kjans123/BME590-LightDHF/Electronics/IMG_3812.JPG

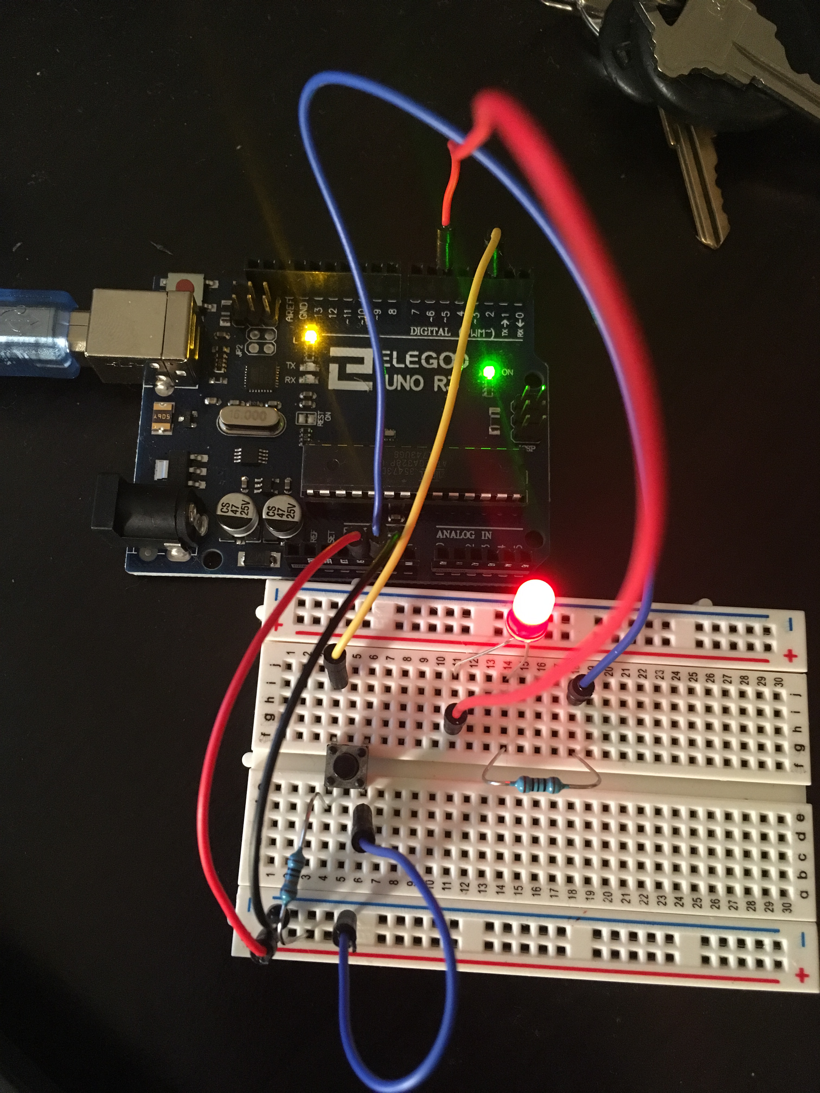
Electronics/IMG_3812.JPG
