kjans123/BME590-LightDHF/Mechanical/LEDlightHolder/JPGs/render.JPG

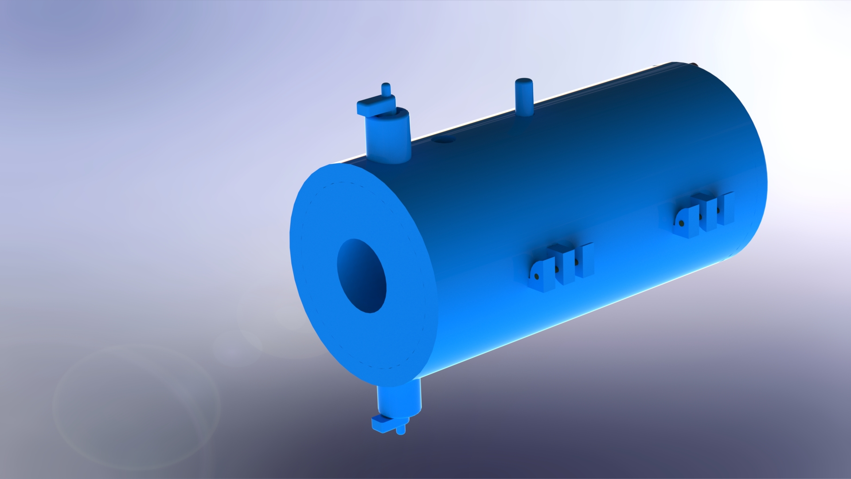
Mechanical/LEDlightHolder/JPGs/render.JPG
