kjans123/BME590-LightDHF/README.md

# BME590-LightDHF
Design History Files & project plan for BME 590 LED light design challenge
test
