kjans123/BME590-LightDHF/Mechanical/MechNotes.txt

10/24/2018:
bulb_grommet_holder V1 is based on 9600K115 grommet from McMaster Carr (https://www.mcmaster.com/9600k115)
the bulb holder for V1 is found here: (https://www.amazon.com/gp/product/B06XRZ3M39/ref=oh_aui_detailpage_o00_s00?ie=UTF8&psc=1)
PRINTED bulb_grommet_holderV1 on 10/24/2018

10/29/2018:
bulb_grommet_holderV2 has outer hole dimension increased from 23mm to 24mm. Also increased lip-hole from 17.46mm to 17.9 mm
PRINTED bulb_grommet_holderV2 on 10/29/2018
