kjans123/BME590-LightDHF/Electronics/ElecNotes.txt

9-27-2018: decided to use analog based design for the BME590 design challenge
10-25-2018: Not going with analog based design. Using Arduino Pro Mini MCU
