kjans123/BME590-LightDHF/Mechanical/ShockConcepts&Filtering.xlsx

Concept # | Concept Desc. | Ease to Design in SW | Ease to find Correct Parts | Expected Weight addition | Expected Shock Absorption | Score
1 | Rubber Feet (heavy rubber feet to absorb shock. If heavy enough, will ensure light rotates mid-air and lands on them due to center of gravity) | 5 | 4 | 1 | 4 | 70%
2 | Suspended electronics inside of flashlight tube (i.e., have an electronics "box" inside tube suspended in mid-air via rubber bands) | 2 | 3 | 4 | 5 | 70%
3 | Anchored electronics inside of flashlight tube (i.e., have an electronics "box" inside tube anchored to tube via rubber, shock-absorbing columns) | 3 | 4 | 3 | 5 | 75% | *
4 | Thick plastic casing + inner foam | 4 | 4 | 2 | 5 | 75%
5 | Thick Rubber banding down the length of the flashlight tube at intervals | 5 | 3 | 3 | 4 | 75% | *
