kjans123/BME590-LightDHF/Docs/Concepts&FilteringDoc.xlsx

Concept # | Concept Desc. | Cost | Time to Implement | Personal Knowledge | Estimated power consumption | Estimated Weight | Score
1) | MCU | 3 | 5 | 5 | 2 | 4 | 76%
2) | Really complex, CAD designed push button to switch between dimming/flashing circuits | 4 | 2 | 4 | 4 | 3 | 68%
3) | Multiple timer chips | 4 | 3 | 3 | 4 | 3 | 68%
4) | Demultiplexer/logic based circuit | 4 | 2 | 1 | 3 | 2 | 48%
 | Scores from 1-5, 5 being most desirable and 1 being least desirable
