kjans123/BME590-LightDHF/Electronics/V2CircuitDiagram.pdf

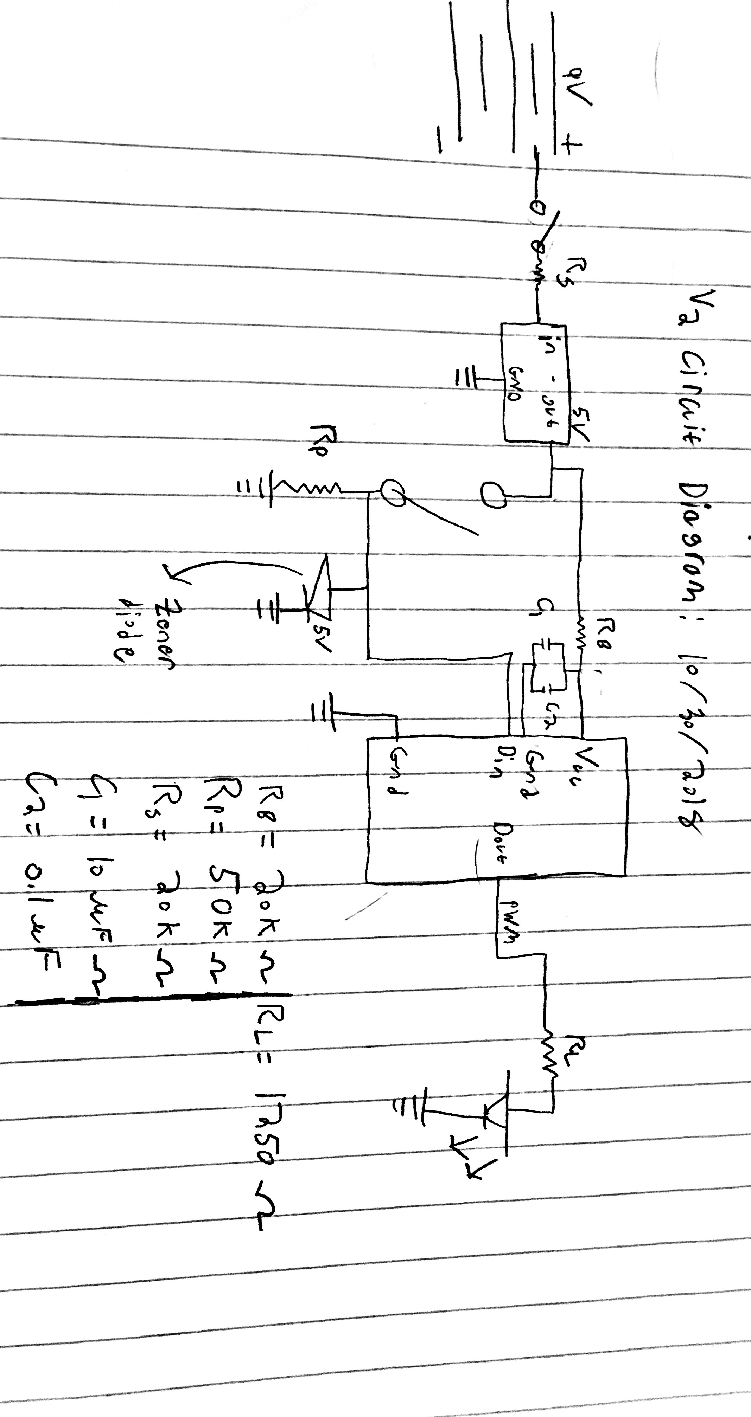
[picture p3: page 1]
