kjans123/BME590-LightDHF/Mechanical/RoughSketchV1.pdf

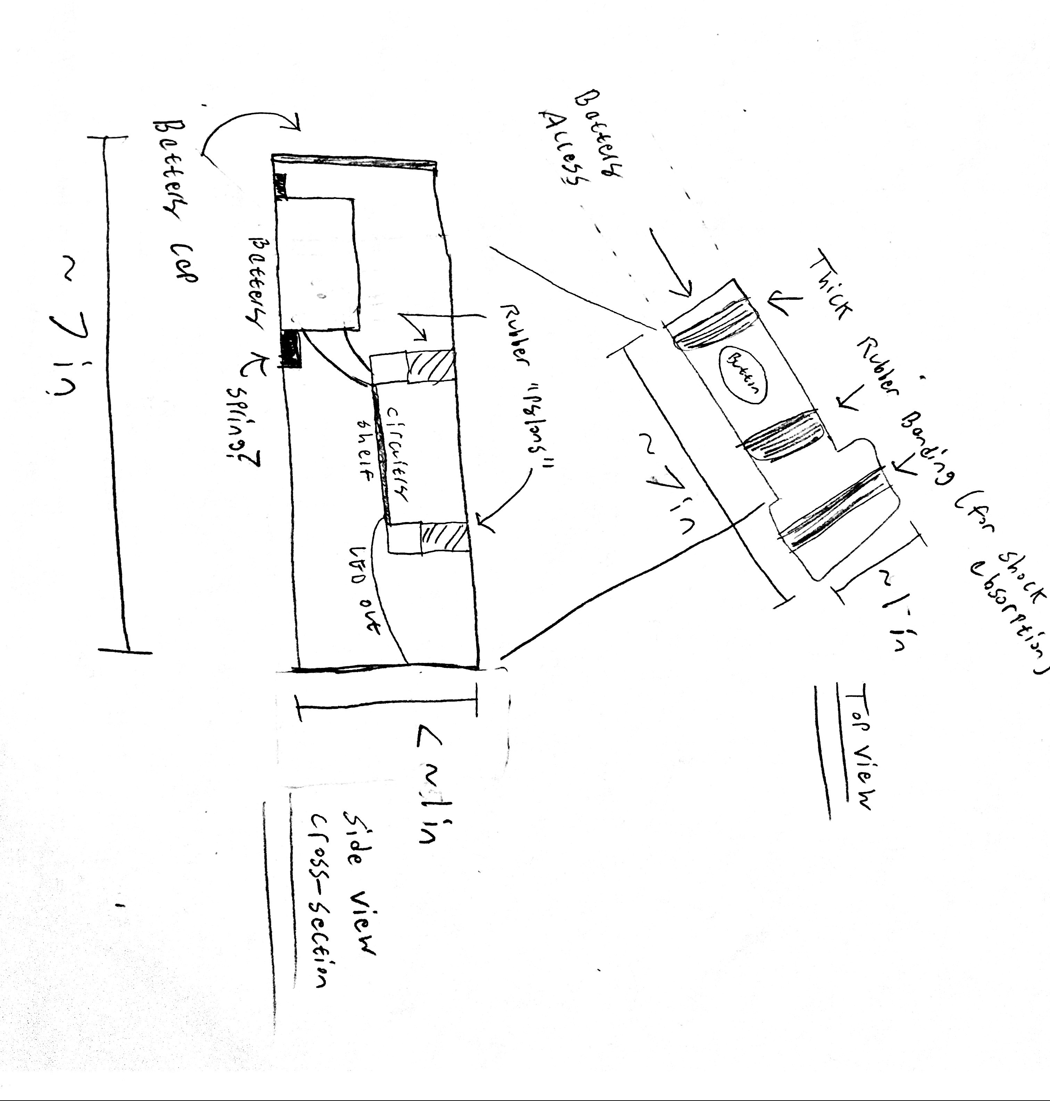
[picture p4: page 1]
