kjans123/BME590-LightDHF/Electronics/FuncBlockDiagram.pdf

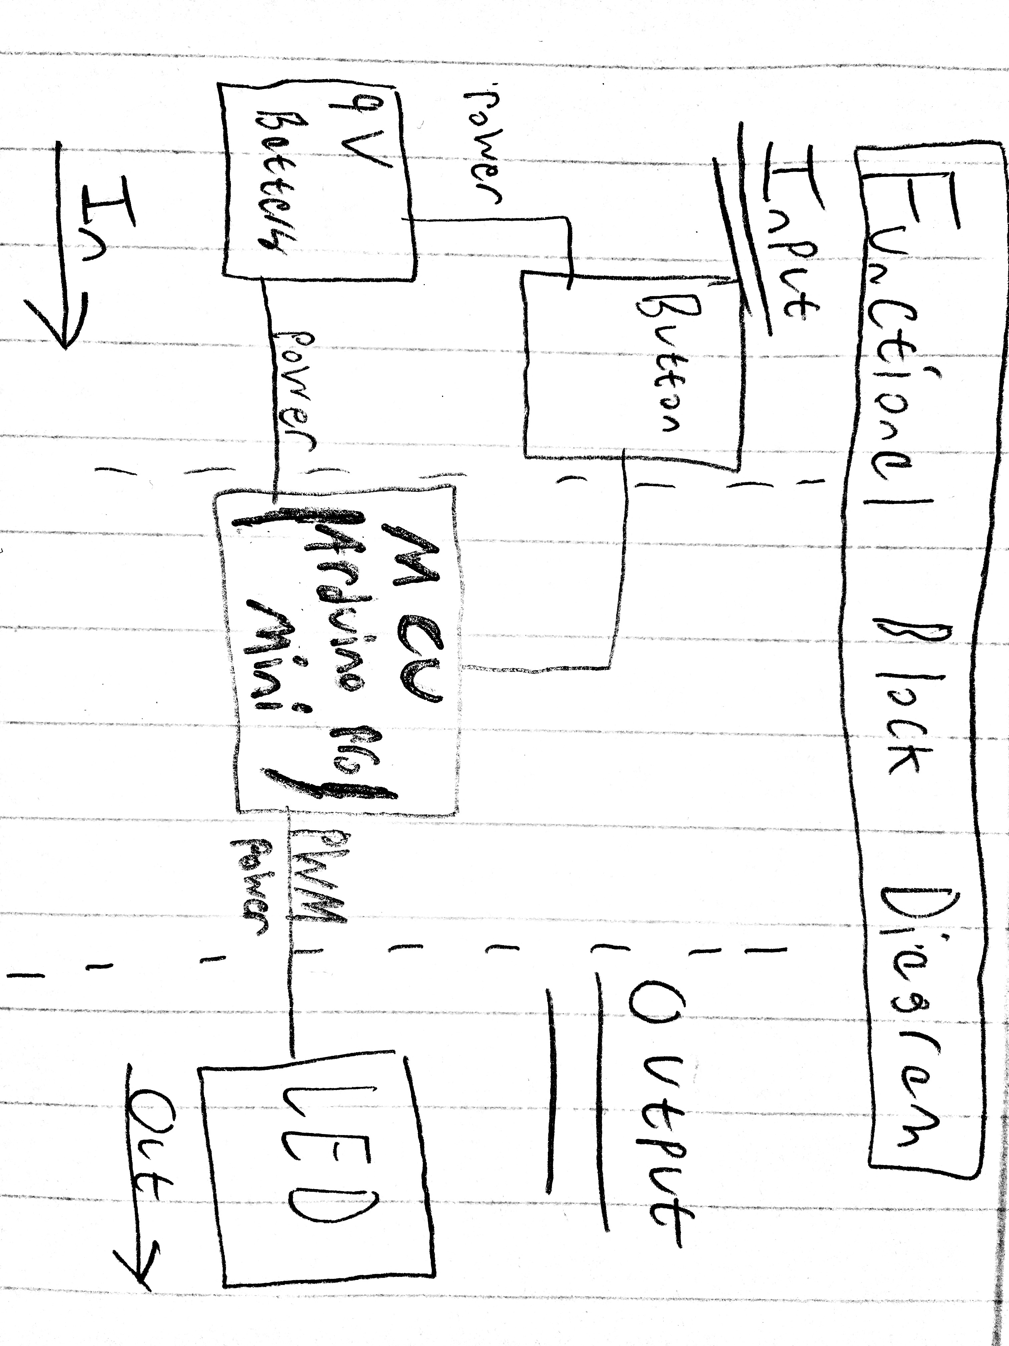
[picture p5: page 1]
