kjans123/BME590-LightDHF/Software/V1SoftwareFlowchart.pdf

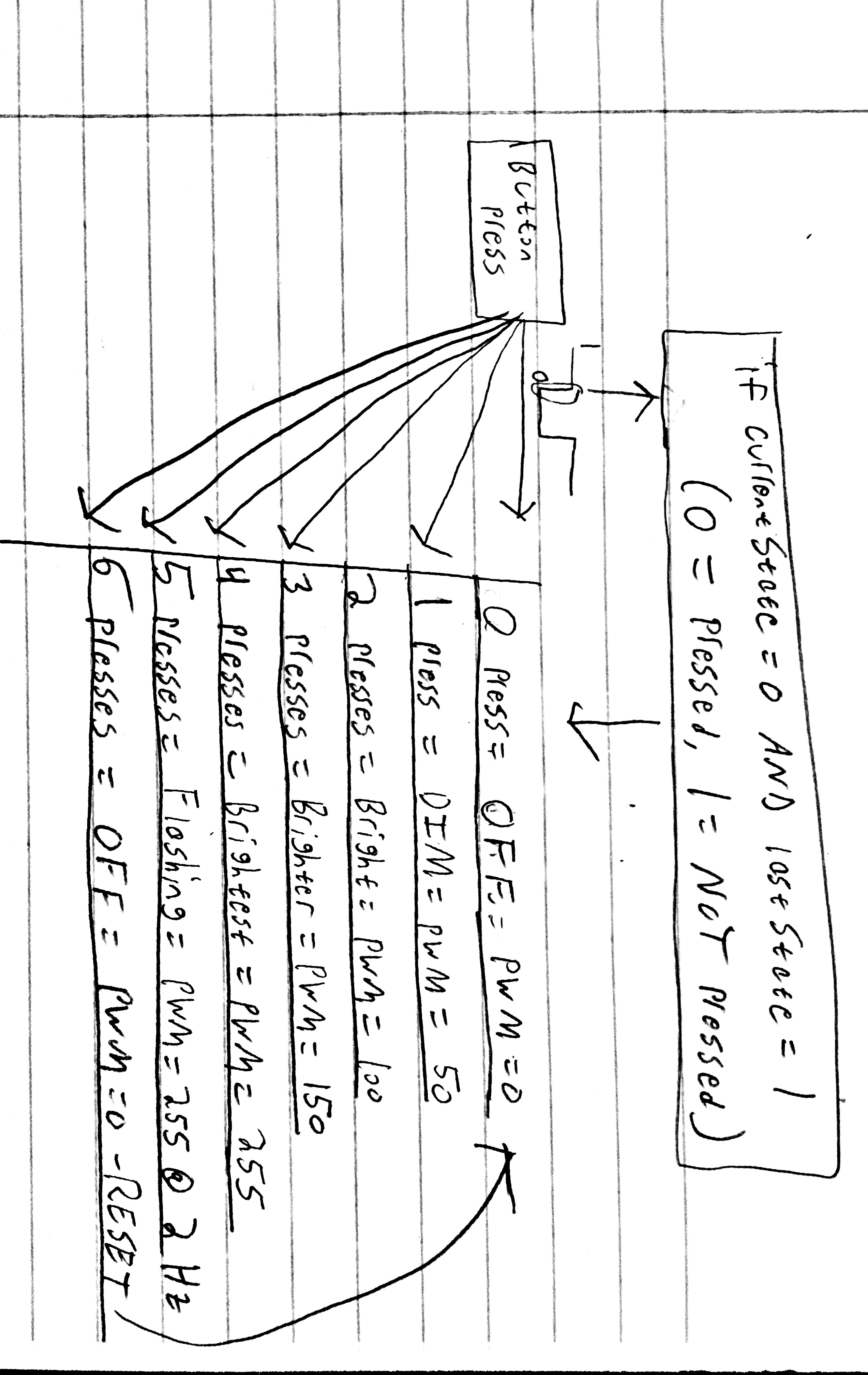
[picture p6: page 1]
