kjans123/BME590-LightDHF/Electronics/Archive/timer555chip_calcs.xlsx

frequency: | 2 | Hz
R1 | 5000 | Ohms | 5k
t1 | 0.2512128972 | second
t2 | 0.2487868868 | second
R2 | 512749 | Ohms | 512.749 | kOhms
1.00975136
C | 6.9999865e-07 | Farads
 | 0.69999865 | uF | .7 uF
 | *will need 2 0.45 uF capacitors in parallel
f | 2.000000864 | Hz
