kjans123/BME590-LightDHF/Electronics/Archive/V1CircuitDiagram.pdf

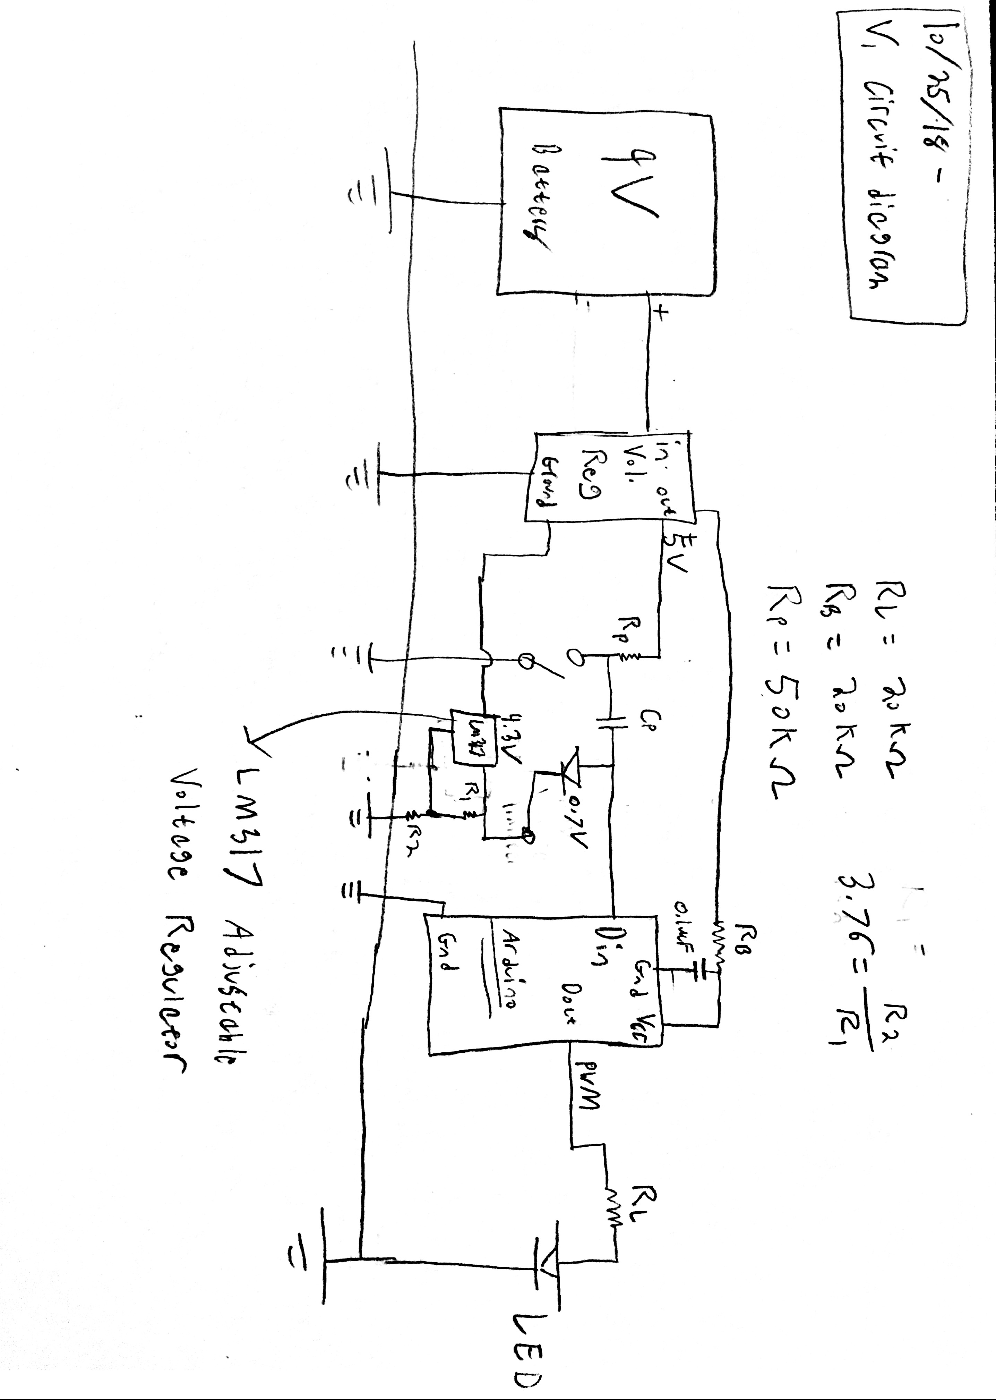
[picture p7: page 1]
