kjans123/BME590-LightDHF/Electronics/eagle_sketch&boardV3/v3board.png

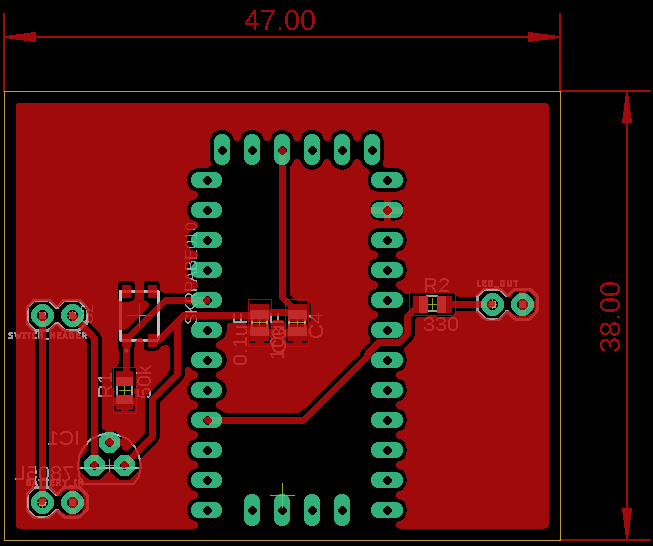
Electronics/eagle_sketch&boardV3/v3board.png
