kjans123/BME590-LightDHF/Electronics/eagle_sketchV1/eagle_sketchV1.png

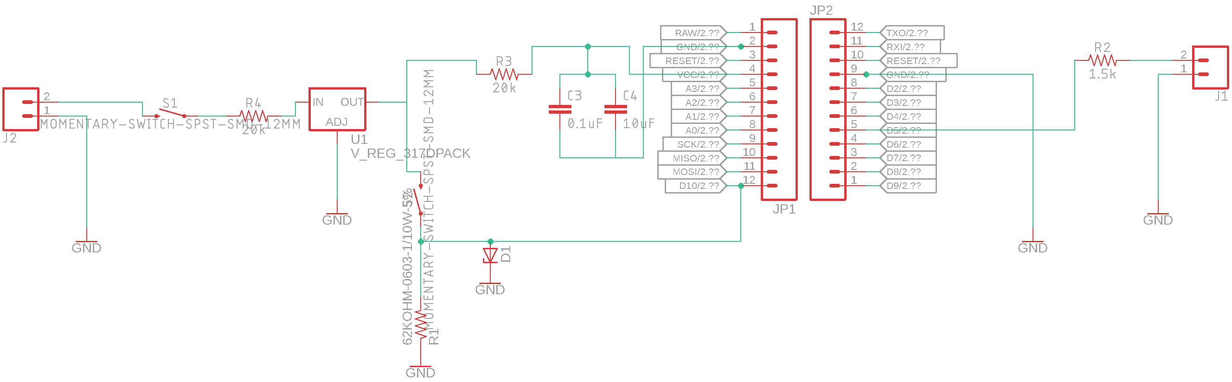
Electronics/eagle_sketchV1/eagle_sketchV1.png
