kjans123/BME590-LightDHF/Mechanical/LEDlightHolder/JPGs/fullAssem2.JPG

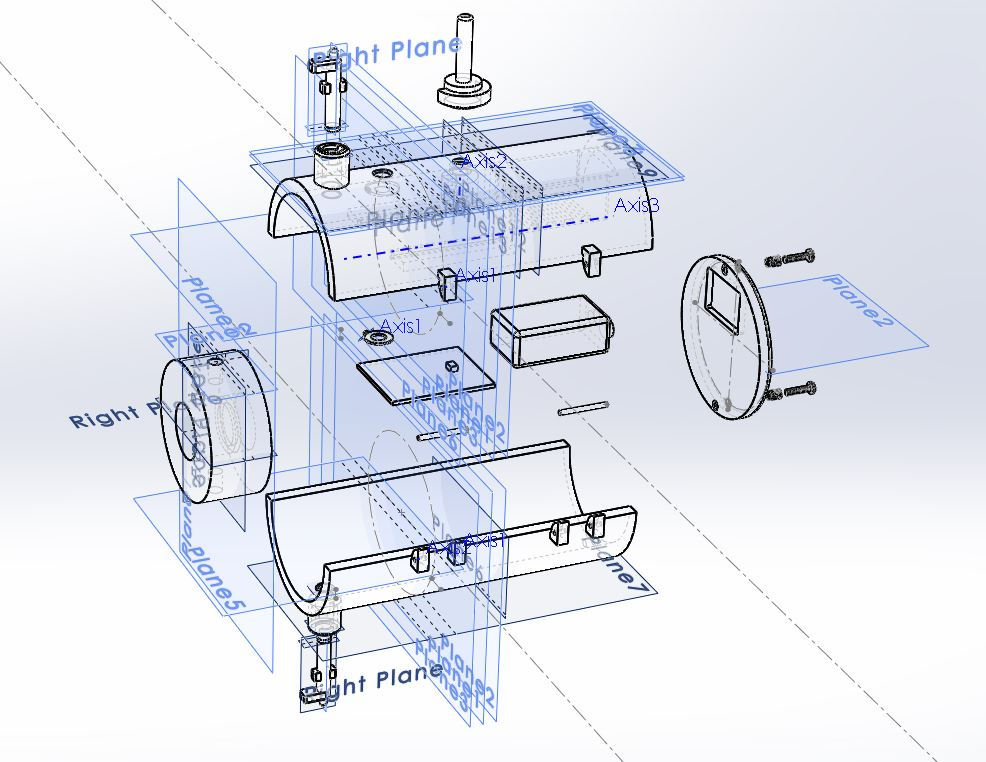
Mechanical/LEDlightHolder/JPGs/fullAssem2.JPG
