kjans123/BME590-LightDHF/Mechanical/LEDlightHolder/JPGs/fullAssem3.JPG

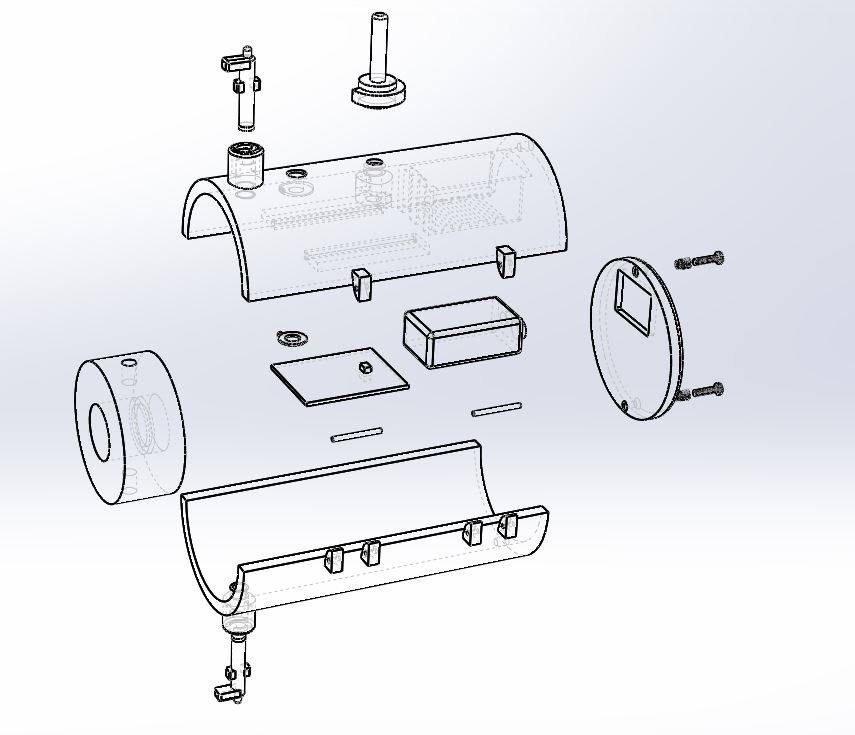
Mechanical/LEDlightHolder/JPGs/fullAssem3.JPG
