kjans123/BME590-LightDHF/Mechanical/LEDlightHolder/JPGs/fullAssem.JPG

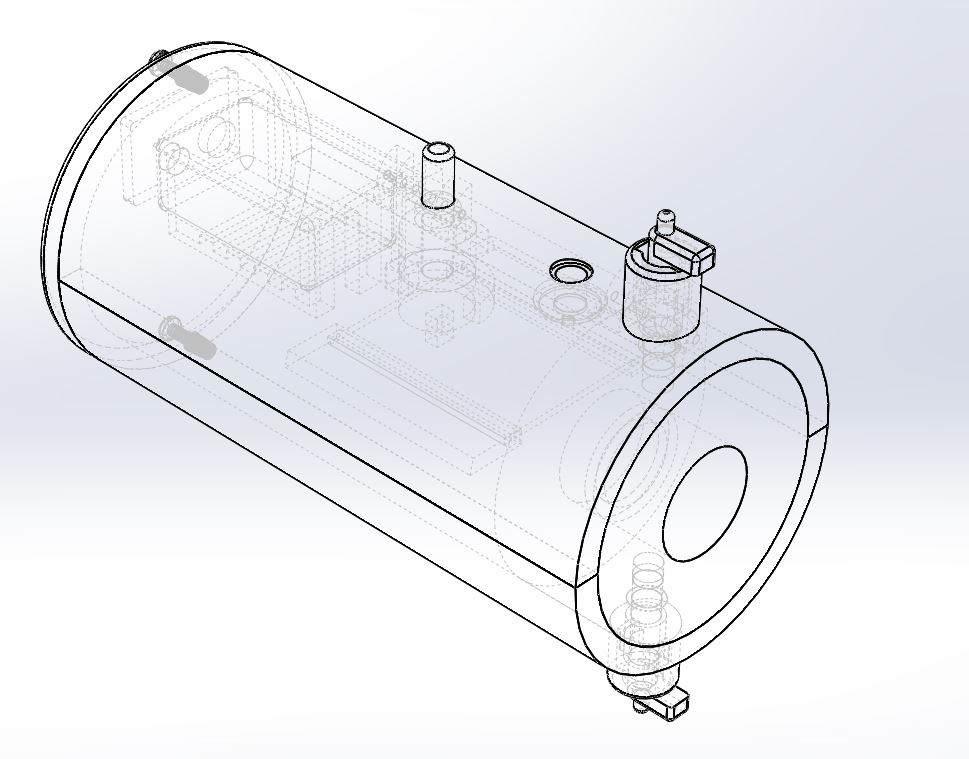
Mechanical/LEDlightHolder/JPGs/fullAssem.JPG
