kjans123/BME590-LightDHF/Mechanical/LEDlightHolder/Main_Enclosure/JPGs/fullAssem4.JPG

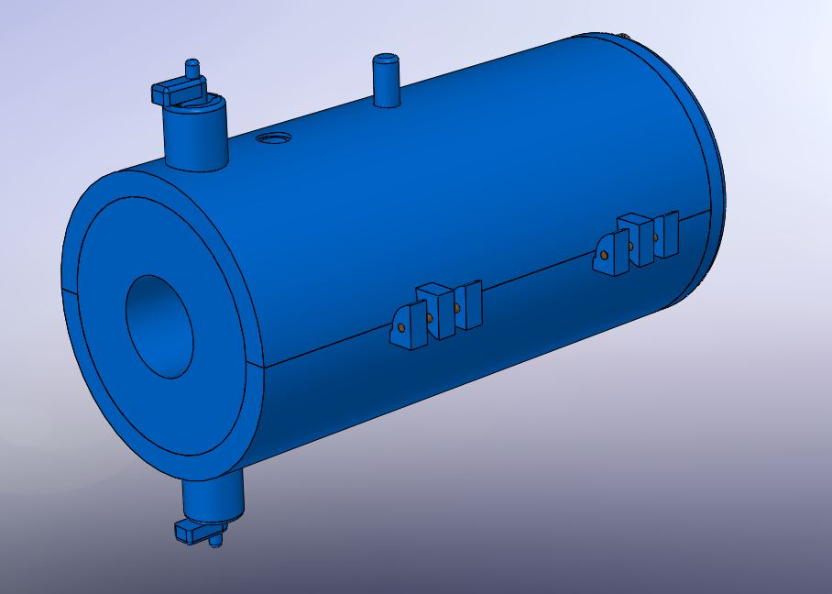
Mechanical/LEDlightHolder/Main_Enclosure/JPGs/fullAssem4.JPG
