kjans123/BME590-LightDHF/Electronics/MCU_details_and_scoring.xlsx

Score | MCU Model | Power Drain on Sleep | Size (LxW) | Cost | Link
4 | Teensy 3.2 | cannot find. Need to test physically | 1.4x0.7in | $24.49 | here (https://www.amazon.com/PJRC-6485230-Teensy-3-2/dp/B015M3K5NG)
1 | Arduino PRO Mini w/ 328P 5V | 54 uA | 1.3x0.71in | $12.99 | here (https://www.amazon.com/Arduino-Pro-Mini-328-16MHz/dp/B004G53J5I)
3 | Arduino Nano V3 | 2 mA | 1.7x0.7in | $4.19 per piece | here (https://www.amazon.com/UCTRONICS-ATmega328P-Controller-Development-Arduino/dp/B07DKZCRQH?s=pc)
5 | Teensy 3.5 | cannot find. Need to test physically | 2.4x0.7in | $27.93 | here (https://www.amazon.com/PJRC-3267-Teensy-3-5/dp/B072JL5C2G)
2 | Teensy 2.0 | 0.23 mA @ 3.3V | 1.2x0.7in | $20.00 | here (https://www.amazon.com/Teensy-2-0/dp/B00NC43256)
