kjans123/BME590-LightDHF/Mechanical/LEDlightHolder/SWParts/fullAssem.SLDASM

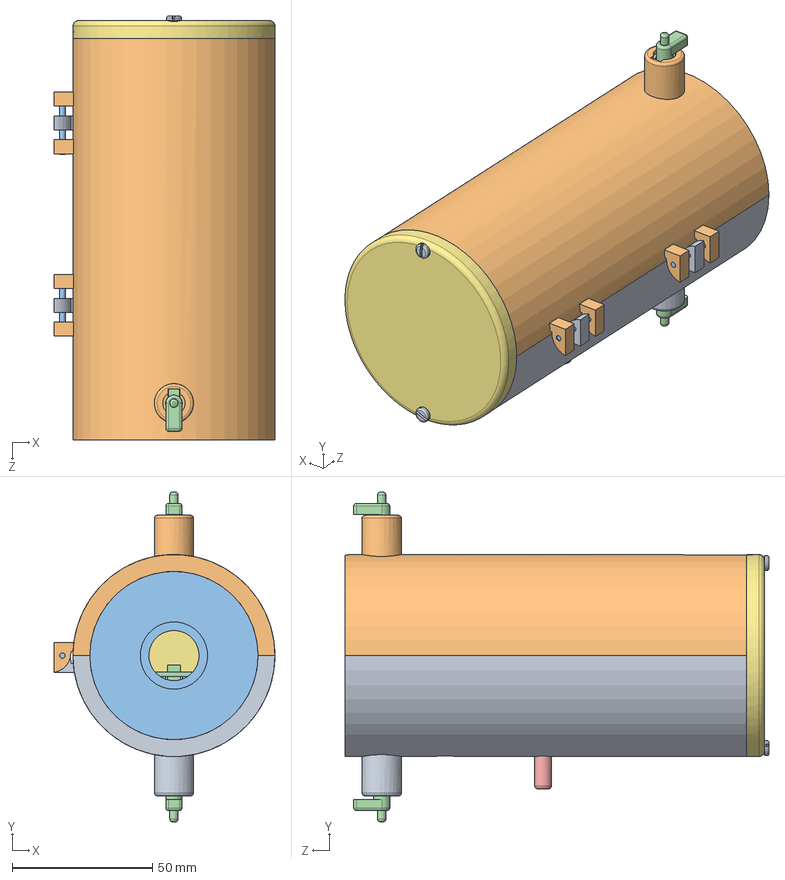
[picture p15: CAD file, 2018-11-29]
Mechanical/LEDlightHolder/SWParts/fullAssem.SLDASM
78.7 x 117.5 x 151.1 mm
main_enc_actualV1_BOTTOM
main_enc_actualV1_TOP
main_enc_hinge_barV1 x 2
pcbDummy
push_button
dummy_battery
bottom
93365A122_HEAT-SET INSERTS FOR PLASTICS x 2
screw-4-40 x 2
locking_washer
bulb_grommet_holderV4
pull_bar x 2
