kjans123/BME590-LightDHF/Mechanical/LEDlightHolder/STLs/main_enc_actualV1_TOP.STL

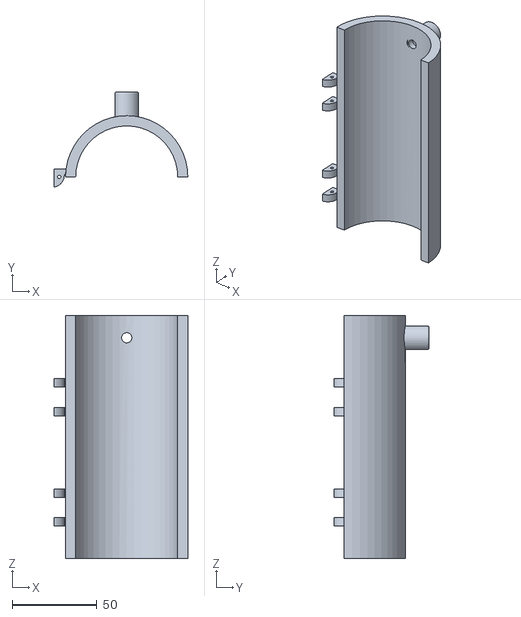
[picture p16: CAD file, 2018-11-29]
Mechanical/LEDlightHolder/STLs/main_enc_actualV1_TOP.STL
78.7 x 56.0 x 143.0
