kjans123/BME590-LightDHF/Mechanical/LEDlightHolder/STLs/main_enc_actualV1_BOTTOM.STL

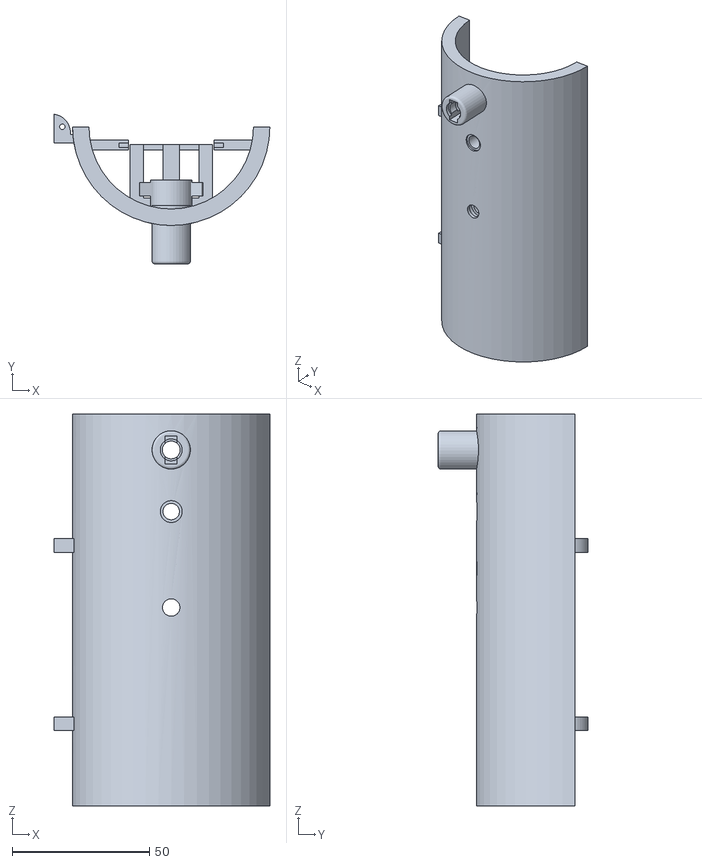
[picture p17: CAD file, 2018-11-29]
Mechanical/LEDlightHolder/STLs/main_enc_actualV1_BOTTOM.STL
78.7 x 54.6 x 143.0
