kjans123/BME590-LightDHF/Mechanical/LEDlightHolder/SWParts/main_enc_hinge_barV1.SLDPRT

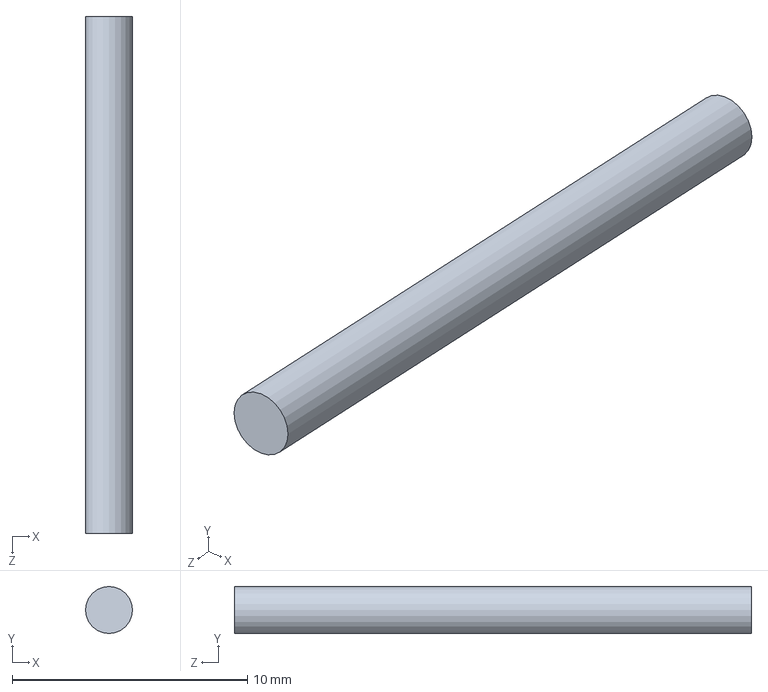
[picture p18: CAD file, 2018-11-18]
Mechanical/LEDlightHolder/SWParts/main_enc_hinge_barV1.SLDPRT
2.00 x 2.00 x 22.0 mm
