kjans123/BME590-LightDHF/Mechanical/LEDlightHolder/shim.SLDPRT

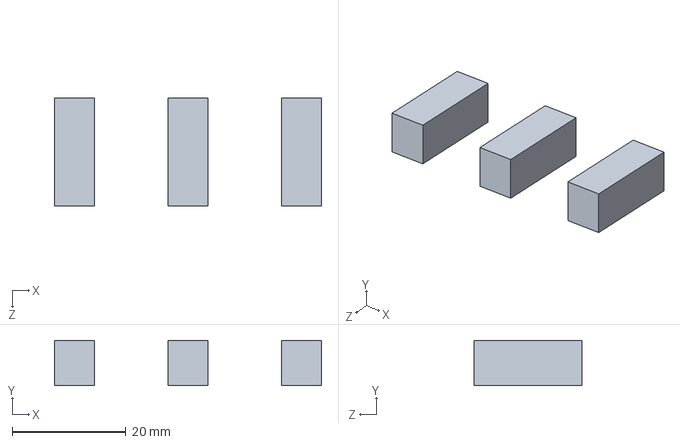
[picture p19: CAD file, 2018-12-06]
Mechanical/LEDlightHolder/shim.SLDPRT
47.0 x 8.00 x 19.0 mm
