kjans123/BME590-LightDHF/Mechanical/LEDlightHolder/STLs/bulb_grommet_holderV4.STL

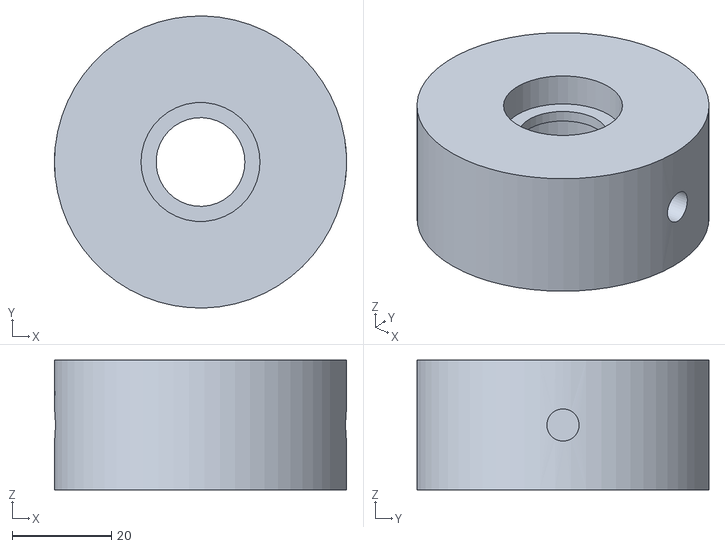
[picture p20: CAD file, 2018-11-29]
Mechanical/LEDlightHolder/STLs/bulb_grommet_holderV4.STL
58.9 x 58.9 x 26.2
