kjans123/BME590-LightDHF/Mechanical/SWParts/bulb_grommet_holderV2.SLDPRT

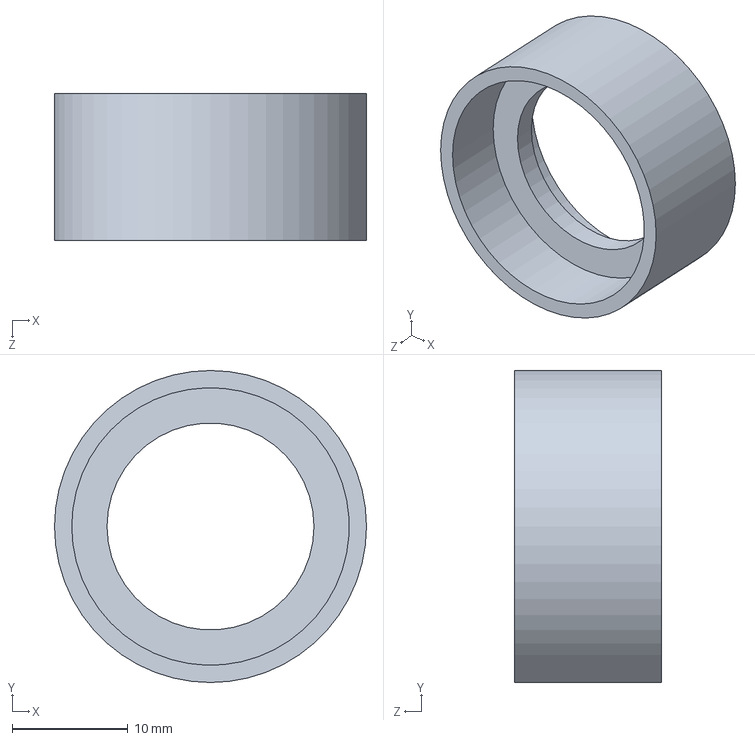
[picture p21: CAD file, 2018-10-29]
Mechanical/SWParts/bulb_grommet_holderV2.SLDPRT
27.0 x 27.0 x 12.7 mm
