kjans123/BME590-LightDHF/Mechanical/LEDlightHolder/STLs/bottom.STL

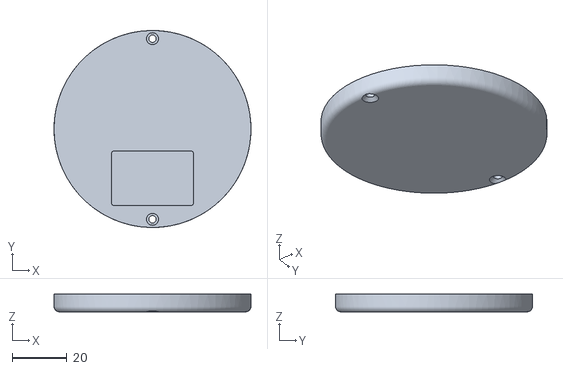
[picture p22: CAD file, 2018-11-29]
Mechanical/LEDlightHolder/STLs/bottom.STL
72.0 x 72.0 x 6.50
