kjans123/BME590-LightDHF/Mechanical/LEDlightHolder/STLs/push_button.STL

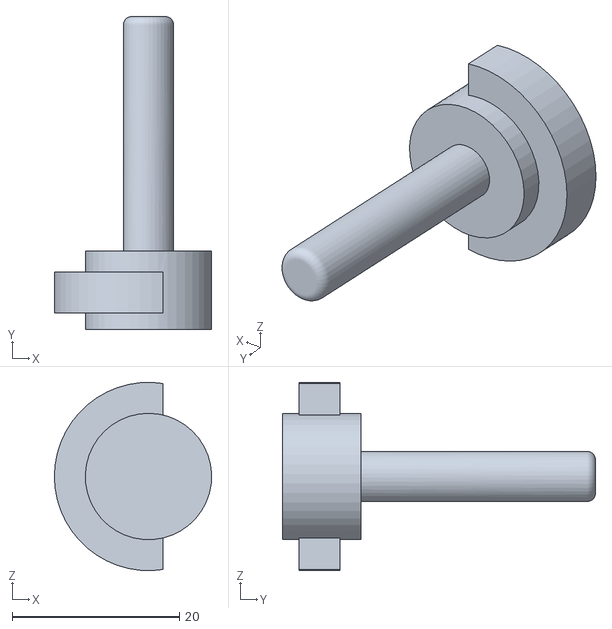
[picture p23: CAD file, 2018-11-29]
Mechanical/LEDlightHolder/STLs/push_button.STL
18.8 x 37.4 x 22.5
