kjans123/BME590-LightDHF/Mechanical/LEDlightHolder/STLs/pull_bar.STL

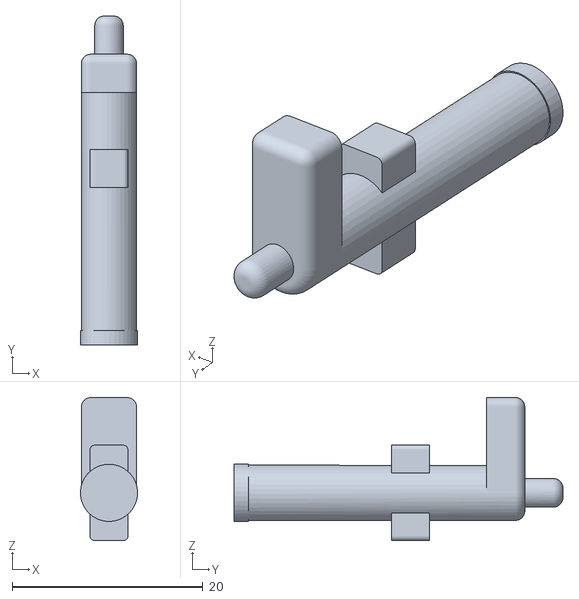
[picture p24: CAD file, 2018-11-29]
Mechanical/LEDlightHolder/STLs/pull_bar.STL
5.99 x 34.5 x 15.0
