kjans123/BME590-LightDHF/Mechanical/LEDlightHolder/STLs/tab.STL

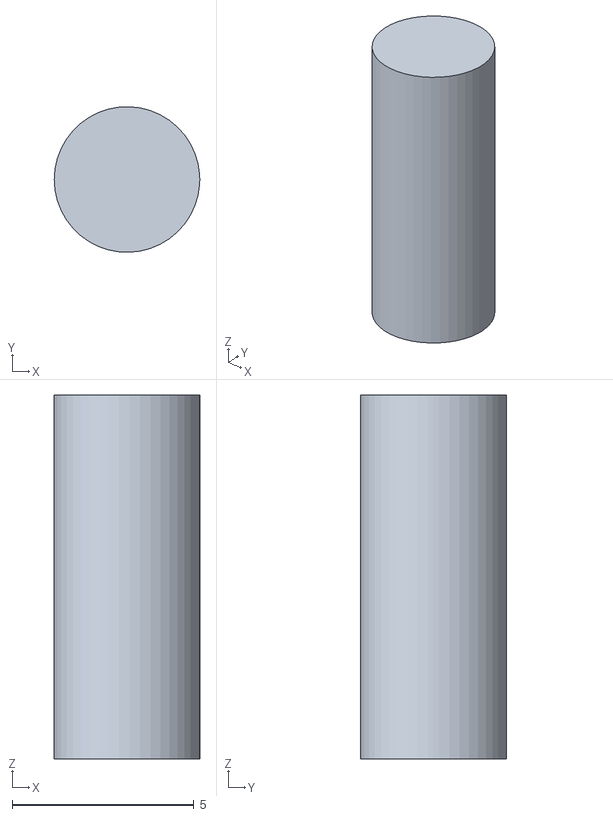
[picture p25: CAD file, 2018-11-29]
Mechanical/LEDlightHolder/STLs/tab.STL
4.00 x 4.00 x 10.0
