kjans123/BME590-LightDHF/Mechanical/LEDlightHolder/SWParts/pcbDummy.SLDPRT

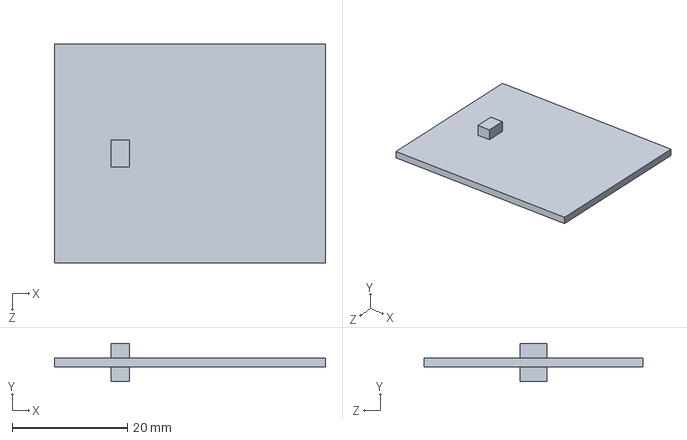
[picture p26: CAD file, 2018-11-18]
Mechanical/LEDlightHolder/SWParts/pcbDummy.SLDPRT
47.0 x 6.60 x 38.0 mm
