kjans123/BME590-LightDHF/Mechanical/LEDlightHolder/SWParts/dummy_battery.SLDPRT

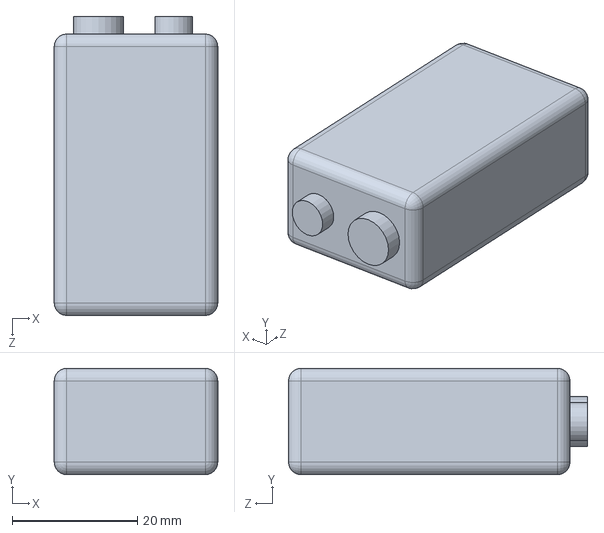
[picture p27: CAD file, 2018-11-18]
Mechanical/LEDlightHolder/SWParts/dummy_battery.SLDPRT
26.1 x 17.0 x 47.8 mm
