kjans123/BME590-LightDHF/(list of files, cad)

Other CAD files:
Mechanical/LEDlightHolder/SWParts/main_enc_actualV1_BOTTOM.SLDPRT
Mechanical/LEDlightHolder/SWParts/main_enc_actualV1_TOP.SLDPRT
Mechanical/LEDlightHolder/SWParts/bulb_grommet_holderV4.SLDPRT
Mechanical/LEDlightHolder/SWParts/bottom.SLDPRT
Mechanical/LEDlightHolder/SWParts/pull_bar.SLDPRT
Mechanical/LEDlightHolder/SWParts/tab.SLDPRT
Mechanical/LEDlightHolder/SWParts/push_button.SLDPRT
Mechanical/LEDlightHolder/Archive/bulb_grommet_holderV1.SLDPRT
Mechanical/LEDlightHolder/Archive/bulb_grommet_holderV1.STL
Mechanical/LEDlightHolder/Archive/bulb_grommet_holderV1p.stl
Mechanical/LEDlightHolder/Archive/bulb_grommet_holderV2.STL
Mechanical/LEDlightHolder/Archive/grommet.SLDPRT
Mechanical/LEDlightHolder/Archive/main_enc_actualV1.SLDPRT
Mechanical/LEDlightHolder/Archive/spring_lock_attempt/bulb_grommet_holderV3.SLDPRT
Mechanical/LEDlightHolder/Archive/spring_lock_attempt/light_holder_grommet_pushbar.SLDPRT
Mechanical/LEDlightHolder/Archive/spring_lock_attempt/light_holder_grommet_pushbar_wing.SLDPRT
Mechanical/LEDlightHolder/Archive/spring_lock_attempt/light_holder_grommet_pushbar_wing2.SLDPRT
Mechanical/LEDlightHolder/Archive/spring_lock_attempt/sub_assem_front_block.SLDASM
Mechanical/LEDlightHolder/SWParts/93365A122_HEAT-SET INSERTS FOR PLASTICS.SLDPRT
Mechanical/LEDlightHolder/SWParts/locking_washer.SLDPRT
Mechanical/LEDlightHolder/SWParts/screw-4-40.SLDPRT
Mechanical/LEDlightHolder/shim.STL
Mechanical/OLD_SWParts/Archive/bulb_grommet_holderV1.SLDPRT
Mechanical/SWParts/bulb_grommet_holderV1.SLDPRT
