kjans123/BME590-LightDHF/(threads)

Thread 7 (2018-10-11):

LED bulb Question

kjans123, 2018-10-11:
Hi Dr. Palmeri, would either of these options work for the LED bulb in the flashlight?

1) https://www.amazon.com/Miniature-Light-Bulbs-Lamps-Lionel/dp/B01N97FT10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

2) https://www.amazon.com/Miniature-Light-Bulbs-Lamps-Multicolor/dp/B01CITEJWA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

mlp6, 2018-10-11:
They are LED, so yep!  Keep in mind the operating voltage range for the first one...

kjans123, 2018-10-11:
Great, thank you!

Closed 2018-10-11.

Thread 12 (2018-10-19):

write code in Sketch for switching LED from dim, brighter, brightest, flashing

kjans123, 2018-10-19:

kjans123, 2018-10-29:
Wrote V1 code: 89a0f07a1132ba5de4b99b6835635aeb298157b1

V1 Code found here: https://github.com/kjans123/BME590-LightDHF/blob/master/Software/SwitchOuputsCode_V1.ino

kjans123, 2018-10-29:
This code is based on this circuit: https://github.com/kjans123/BME590-LightDHF/blob/master/Electronics/IMG_3812.JPG

kjans123, 2018-10-31:
Wrote V2 code: 8df385f0e953ded2c57d06d03055b4ca56d7ea03

V2 code found here: https://github.com/kjans123/BME590-LightDHF/blob/master/Software/SwitchOuputsCode_V1/SwitchOuputsCode_V1.ino

Based on this circuit: https://github.com/kjans123/BME590-LightDHF/blob/master/Electronics/V2CircuitDiagram.pdf

Closed 2018-11-02.

Thread 13 (2018-10-19):

build bare minimum circuit with Arduino platform & breadboard

kjans123, 2018-10-19:
can use basic button that comes with Arduino kit and basic LED kit bulb. Does not have to use final bulb or button. Build circuit w/ breadboard and Nano.

Closed 2018-10-29.

Thread 8 (2018-10-19):

Determine best MCU to use

kjans123, 2018-10-19:
Create xlsx sheet to score a few different MCU's and pick appropriate MCU (i.e., score is based on dimensions, weight, power drain on idle, etc).

kjans123, 2018-10-19:
Arduino Pro Mini 5V version

Closed 2018-10-19.

Thread 9 (2018-10-19):

determine LED bulb holder and battery holder

kjans123, 2018-10-19:

kjans123, 2018-10-24:
Will design battery holder in SW.

Using this LED bulb holder: https://www.amazon.com/gp/product/B06XRZ3M39/ref=oh_aui_detailpage_o00_s00?ie=UTF8&psc=1

Using these connections for 9V battery: https://www.amazon.com/gp/product/B00NIPC9AS/ref=oh_aui_detailpage_o01_s00?ie=UTF8&psc=1

Closed 2018-10-24.

Thread 14 (2018-10-24):

determine power draw of MCU & LED bulb

kjans123, 2018-10-24:
Determine power draw of pro mini + LED bulb

kjans123, 2018-11-29:
with current schematic (https://github.com/kjans123/BME590-LightDHF/blob/master/Electronics/eagle_sketch%26boardV3/v3sketch.png) and with LED bulb at full brightness, power draw of entire circuit is 0.029 Amps.

Closed 2018-11-29.

Thread 16 (2018-10-24):

Determine & buy battery

kjans123, 2018-10-24:
Need to determine and buy battery

kjans123, 2018-10-24:
Will use this 9V battery: https://www.amazon.com/gp/product/B06Y64ZHF2/ref=oh_aui_detailpage_o01_s00?ie=UTF8&psc=1

Closed 2018-10-24.

Thread 19 (2018-10-26):

V1 of Circuit Diagram

kjans123, 2018-10-26:
Hi Dr. Palmeri, here is my first attempt at the circuit diagram. I am trying to use an LM317 Adjustable Voltage Regulator (https://www.onsemi.com/pub/Collateral/LM317-D.PDF), but am not sure if I have it drawn correctly. It is used as an offset to the 0.7V voltage clipper. Does that portion of the circuit look okay?
https://github.com/kjans123/BME590-LightDHF/blob/master/Electronics/V1CircuitDiagram.pdf

mlp6, 2018-10-29:
This is a bit overkill for what you want... we probably have Zener diodes in the lab with a breakdown voltage of 5 V that will do this much easier.  The DC offset will do it too, but in this case, too much hardware to get the voltage threshold that you want.

What EDA software do you plan to use?

kjans123, 2018-10-29:
Oh, sounds great! I'd totally be fine with simplifying that circuit a bit. I am planning on using Eagle.

Closed 2018-10-31.

Thread 22 (2018-10-31):

V2 Circuit Diagram Review

kjans123, 2018-10-31:
Hi Dr. Palmeri, how does this circuit look? I added the Zener diode, two bypass caps in parallel on the Vcc line going into the MCU and a master switch next to the battery.

https://github.com/kjans123/BME590-LightDHF/blob/master/Electronics/V2CircuitDiagram.pdf

mlp6, 2018-11-01:
In general, this looks good!

kjans123, 2018-11-01:
Great, thank you!

Closed 2018-11-01.

Thread 23 (2018-11-01):

V2 Arduino Code Delay Problems

kjans123, 2018-11-01:
Sorry for the multiple issue assigns, but I've hit (more than) a bit of a sticking point in my Arduino code. The state switches work well for brightness switching, but when the LED starts flashing, hitting the button often does nothing. I know this is because the loop is getting delayed and the Arduino is not "seeing" the button press...but I am not sure how to solve the issue. I am using a code interrupt, but I think I may have it catching in the wrong place.

Code: https://github.com/kjans123/BME590-LightDHF/blob/master/Software/SwitchOuputsCode_V1/SwitchOuputsCode_V1.ino

mlp6, 2018-11-01:
Yep, the `delay()` command is causing the `loop()` to stall, so you're really throwing off the timing.  Check out: https://playground.arduino.cc/Code/Timer

kjans123, 2018-11-02:
I GOT IT!!!! I ended up making use of millis().

Closed 2018-11-02.

Thread 28 (2018-11-08):

swap out Uno in bare minimum breadboard circuit for Pro Mini

kjans123, 2018-11-08:

Closed 2018-11-29.

Thread 30 (2018-11-08):

Review of ECAD designs

kjans123, 2018-11-08:
The folder in my repo for the ECAD files is located here:

https://github.com/kjans123/BME590-LightDHF/tree/master/Electronics/eagle_sketch%26boardV3

Thank you!

sphaerobolus, 2018-11-12:
I'm not sure where you're going with JP1, JP2 and JP3. what connects there?

You could optimize routing. Traces here are convoluted.

On the PCB, there are several dangling pins: Battery, LEDHOLES, IC1, Zener.

Not a good idea to implement a device through the use of two separate footprints (switchpad1 and 2).

What's the purpose of the Zener?

What's the purpose of R3?

LEDHOLES and BATTERY shouldn't be power resistors. If they're off-board, make them headers.

kjans123, 2018-11-12:
Make footprints for Arduino pro mini and smd switch. Put 2pin headers in at 0.1" pitch for LED and battery. Remove Zener. Remove R3. Make traces straighter.

Need to figure out how to make footprints. Make board MUCH smaller (roughly the size of the Pro Mini).

kjans123, 2018-11-14:
Hello, I updated the board and schematic with the above suggestions:

board & schematic: https://github.com/kjans123/BME590-LightDHF/tree/master/Electronics/eagle_sketch%26boardV3

the custom-made library part for the smd switch is here: https://github.com/kjans123/BME590-LightDHF/blob/master/Electronics/DIPswitchLib.lbr
I was able to find a custom footprint for the Arduino Pro Mini on GitHub.

sphaerobolus, 2018-11-14:
Looking good!

Closed 2021-06-04.
