kjans123/BME590-LightDHF/Electronics/eagle_sketch&boardV3/eagle_designV3.brd

## EAGLE design Electronics/eagle_sketch&boardV3/eagle_designV3.brd (2018-11-29)

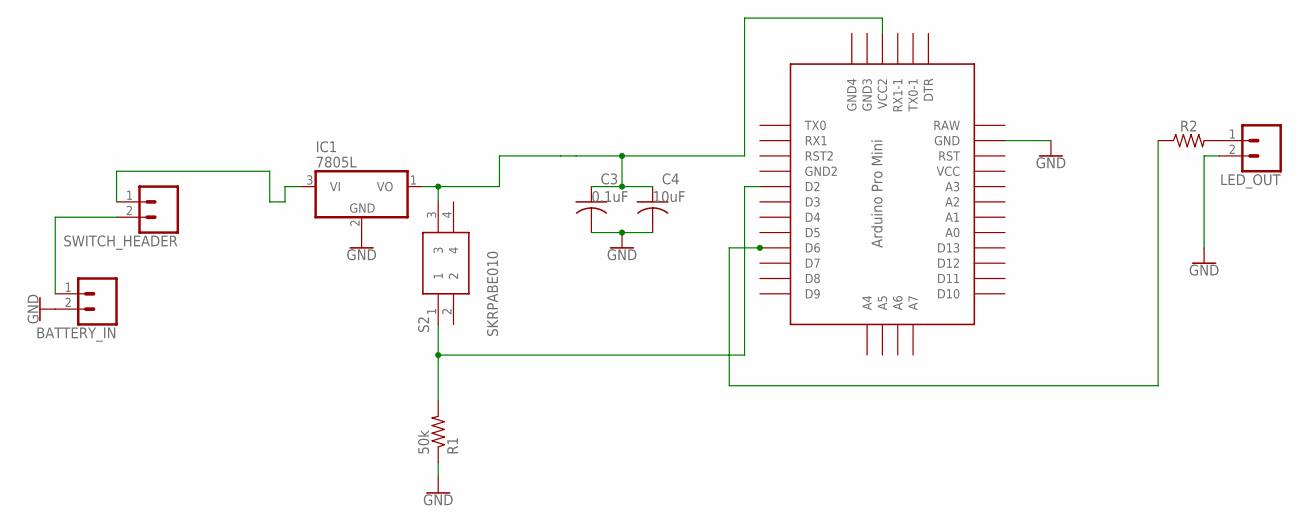
[picture p29: schematic eagle_designV3.sch]

Parts:
BATTERY_IN: CONN_02; 1X02
C3: 0.1uF; C0805
C4: 10uF; C0805
IC1: 7805L; TO92
LED_OUT: CONN_02; 1X02
R1: 50k; R0805
R2: 330; R0805
S2: SKRPABE010; SMT(4.2X3.2)
SWITCH_HEADER: CONN_02; 1X02
U$1: PRO-MINI

Connections:
GND: BATTERY_IN.2, C3.2, C4.2, IC1.2 (GND), LED_OUT.2, R1.1, U$1.GND
unnamed: BATTERY_IN.1, SWITCH_HEADER.2
unnamed: IC1.3 (VI), SWITCH_HEADER.1
unnamed: C3.1, C4.1, IC1.1 (VO), S2.3, U$1.VCC1 (VCC2)
unnamed: R1.2, S2.1, U$1.D2
unnamed: R2.1, U$1.D6
unnamed: LED_OUT.1, R2.2
RAW: U$1.RAW

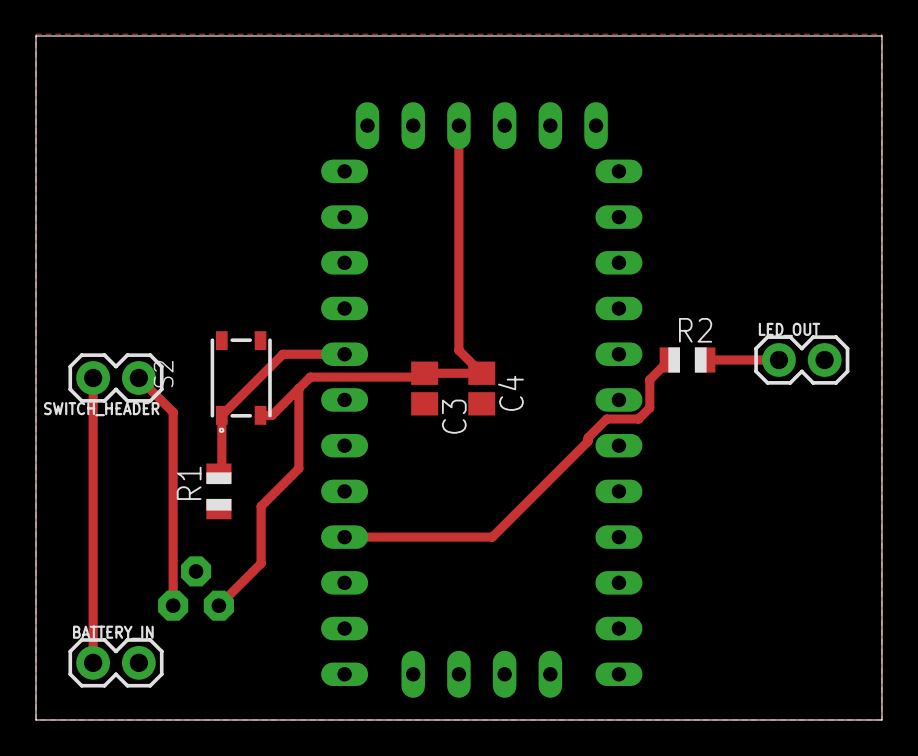
[picture p30: board eagle_designV3.brd from above]

Board: 2 copper layers, 47.0 x 38.0 mm, 10 parts (1 on the bottom side), 7 nets.
