kjans123/BME590-LightDHF/(commit log)

2018-09-28 initial commit for Milestone1 assignment
    [timer555chip_calcs.xlsx]
2018-09-28 added timer chip to electronics BOM txt file (close #1)
2018-09-28 decided to use analog design for LED light (close #2)
2018-10-05 added initial concepts and filtering workbook (closes #5)
    [Concepts&FilteringDoc.xlsx]
2018-10-19 removed timer chip entry to reflect change from analog solution to MCU solution (close #3)
2018-10-19 researched different MCU's. Decided on Arduino Pro Mini (close #8)
    [MCU_details_and_scoring.xlsx]
2018-10-20 changed pro mini link and price
    [MCU_details_and_scoring.xlsx]
2018-10-24 added concepts and filtering for shock absorption (close #17)
    [ShockConcepts&Filtering.xlsx]
2018-10-24 moved Shock xlsx file to Mechanical folder
    [ShockConcepts&Filtering.xlsx]
2018-10-25 model V1 of bulb holder. Based design on grommet 9600K115 from McMaster Carr
    [ShockConcepts&Filtering.xlsx, bulb_grommet_holderV1.SLDPRT]
2018-10-25 Print update
2018-10-26 version 1 of circuit diagram(closes #18)
2018-10-26 added version 1 of very rough sketch of physical enclosure (closes #6)
2018-10-29 initial code for Switching LED outputs
2018-10-29 built bare minimum breadboard circuit with LED and basic pushbutton (closes #13)
2018-10-29 V1 software flowchart for MCU (closes #21)
2018-10-29 changed V1 holder after testing physical grommet so that dimensions are larger (changed outer hole dimension and lip-hole dimension)
    [bulb_grommet_holderV1.SLDPRT, bulb_grommet_holderV2.SLDPRT]
2018-10-31 updated circuit diagram to add Zener diode, master switch and parallel bypass caps
    [timer555chip_calcs.xlsx]
2018-10-31 added Archive folder for old docs
    [timer555chip_calcs.xlsx]
2018-10-31 version 2 code for SwitchOutputsCode_V1.ino
2018-11-02 wrote working code to get light to switch brigtnesses & flash (close #12)
2018-11-03 first pass at creating a VERY rough circuit schematic in Eagle
    [v1_circuit_EAGLE.sch]
2018-11-03 image of v1 eagle schematic
2018-11-08 built board and refined schematic for V2 circuit (closes#10, closes #24)
    [eagle_designV3.brd, eagle_designV3.sch, v1_circuit_EAGLE.sch]
2018-11-14 updated board and schematic with post review suggestions from Issue 30
    [eagle_designV3.brd, eagle_designV3.sch]
2018-11-17 updated board to reflect toggle switch change
    [eagle_designV3.brd, eagle_designV3.sch]
2018-11-18 first REAL versions of every part for enclosure
    [bottom.SLDPRT, bulb_grommet_holderV1.SLDPRT, bulb_grommet_holderV1.STL, bulb_grommet_holderV1p.stl, bulb_grommet_holderV2.SLDPRT, bulb_grommet_holderV2.STL, bulb_grommet_holderV3.SLDPRT, bulb_grommet_holderV4.SLDPRT]
2018-11-29 updated board and schematic to reflect removal of resistor btwn battery and voltage reg
    [eagle_designV3.brd, eagle_designV3.sch]
2018-11-29 changed software to reflect change of PIN-OUT to pin 6 on Pro Mini
2018-11-29 changed bottom piece, pull bar piece and grommet_holder to updateneeded changes after initial prints
    [93365A122_HEAT-SET INSERTS FOR PLASTICS.SLDPRT, bottom.SLDPRT, bottom.STL, bulb_grommet_holderV4.SLDPRT, bulb_grommet_holderV4.STL, fullAssem.SLDASM, main_enc_actualV1_BOTTOM.STL, main_enc_actualV1_TOP.STL]
2018-11-29 changed bulb_grommet holder to have wider pin holes and smaller overall diameter
    [bulb_grommet_holderV4.SLDPRT, bulb_grommet_holderV4.STL]
2018-12-06 ensuring all mech files are updated
    [93365A122_HEAT-SET INSERTS FOR PLASTICS.SLDPRT, bottom.SLDPRT, bottom.STL, bulb_grommet_holderV4.SLDPRT, bulb_grommet_holderV4.STL, dummy_battery.SLDPRT, fullAssem.SLDASM, locking_washer.SLDPRT]
